claitz/Lovebox-WebSocket/STL/Top_screen.stl

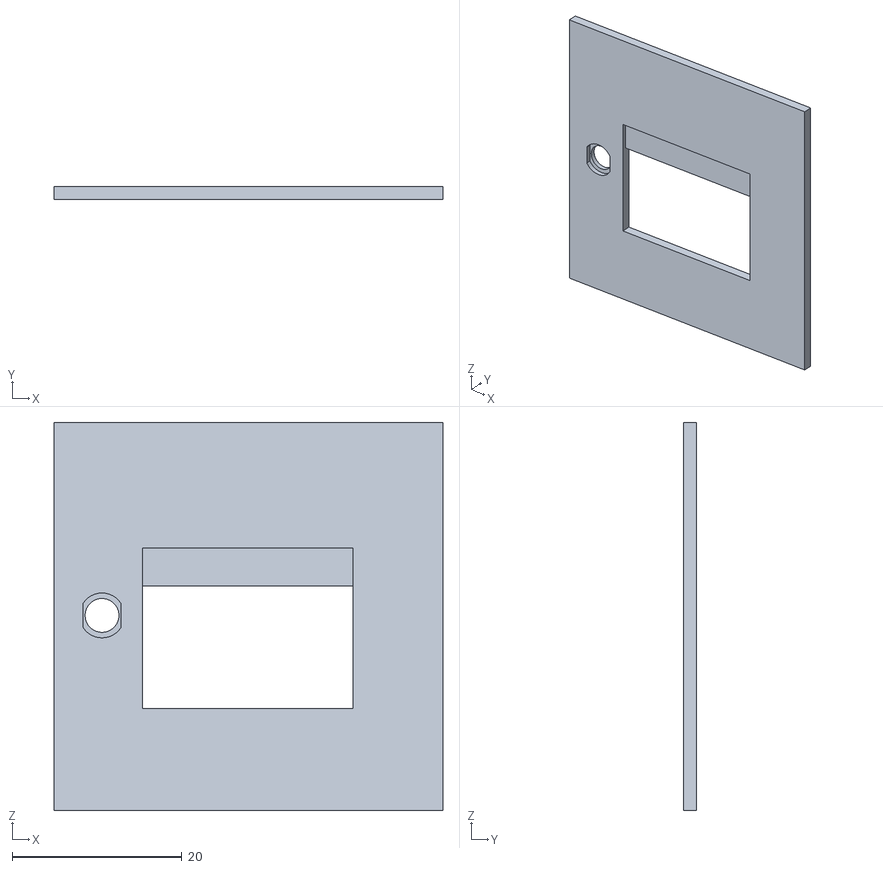
[picture p4: CAD file, 2021-02-07]
STL/Top_screen.stl
45.9 x 1.50 x 45.8
