claitz/Lovebox-WebSocket/STL/Heart_flat.stl

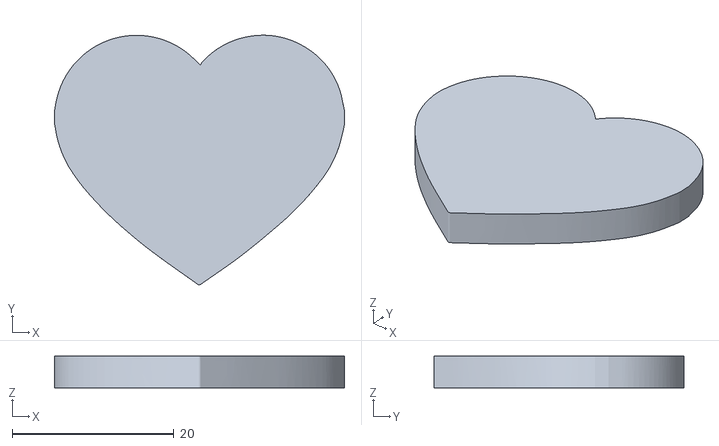
[picture p5: CAD file, 2021-02-07]
STL/Heart_flat.stl
35.8 x 30.8 x 3.95
