claitz/Lovebox-WebSocket/STL/Top_cover.stl

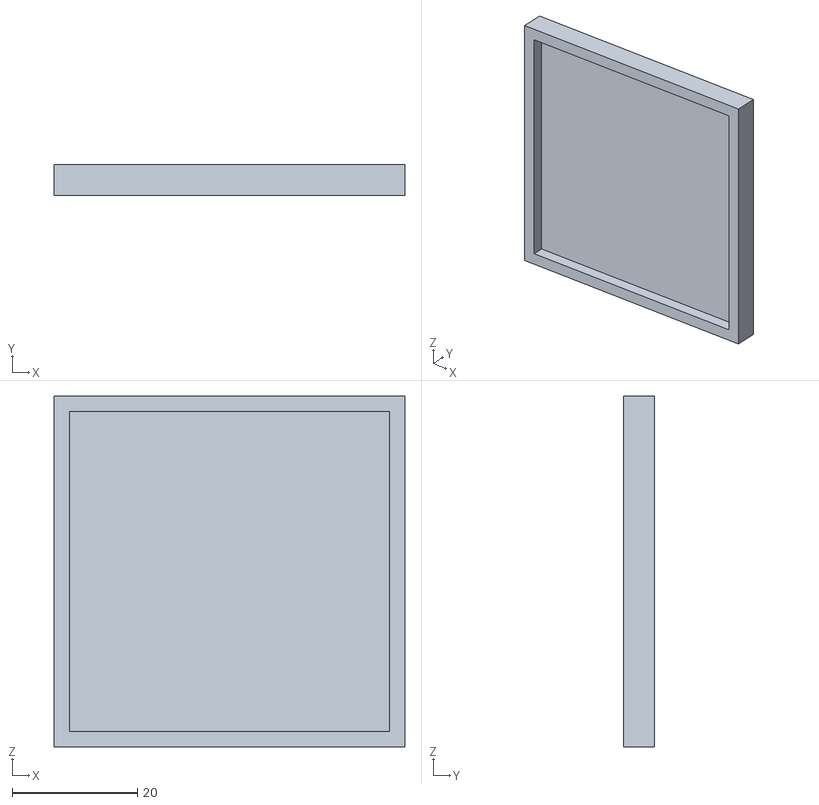
[picture p6: CAD file, 2021-02-07]
STL/Top_cover.stl
56.0 x 5.00 x 56.0
