claitz/Lovebox-WebSocket/STL/Box.stl

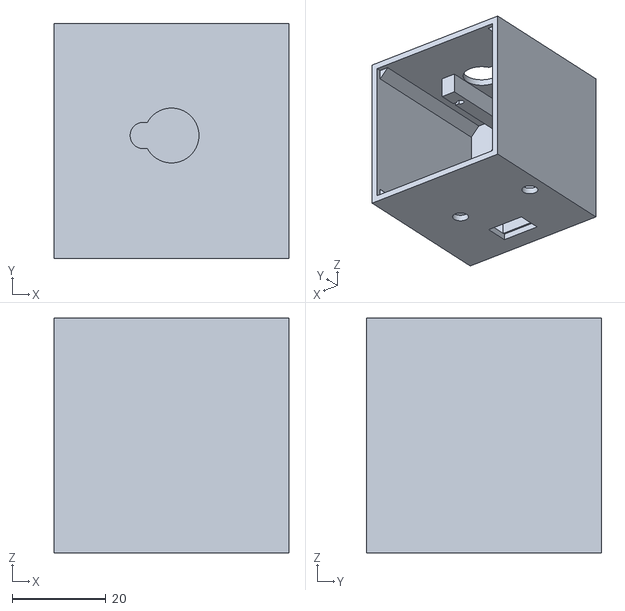
[picture p7: CAD file, 2021-02-07]
STL/Box.stl
50.0 x 50.0 x 50.0
