claitz/Lovebox-WebSocket/STL/Heart.stl

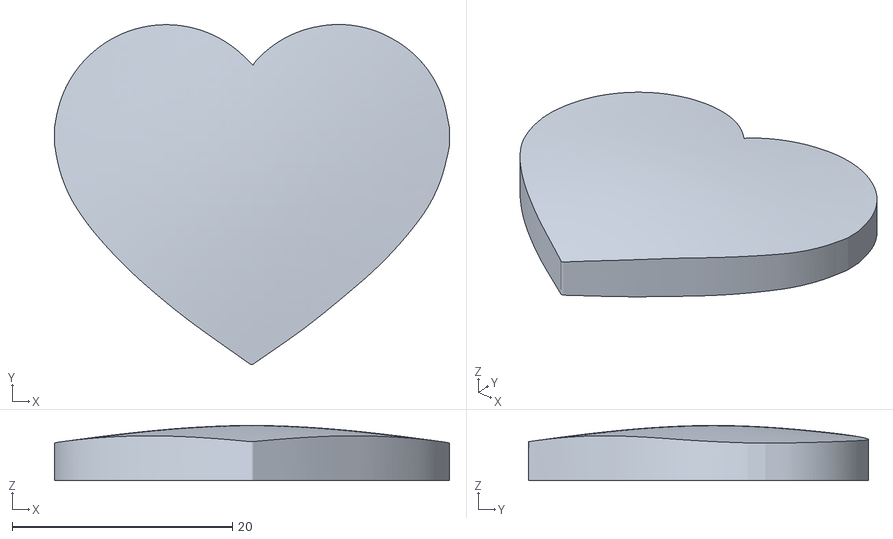
[picture p8: CAD file, 2021-02-07]
STL/Heart.stl
35.8 x 30.8 x 5.00
