claitz/Lovebox-WebSocket/(commit log)

2021-02-07 Repository init
    [Box.stl, Hearth.stl, Top_cover.stl, Top_screen.stl]
2021-02-07 BOM updated
2021-02-07 Design update
    [Heart.stl, Heart_flat.stl, Top_screen.stl]
2021-02-07 Top cover adjustments
    [Top_screen.stl]
